StefanVlad01/Straight-toothed-bevel-gear-reducer/Assembly.SLDASM

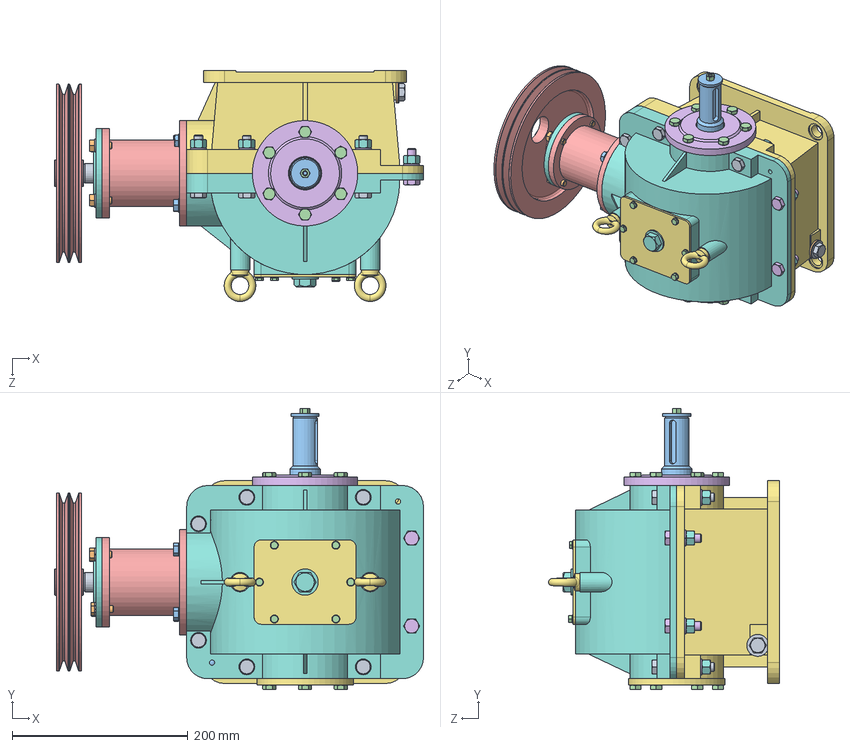
[picture p1: CAD file, 2023-03-10]
Assembly.SLDASM
420.1 x 320.4 x 263.0 mm
Arbore de intrare_1
taper roller bearing_din x 4
Arbore de iesire
Roata_condusa
Caseta rulment arbore intrare
Capac de fixare tip 2
Capac de fixare tip 1
Capac rulment arbore intrare
SKF_KM_5
SKF_MB_5
Inel
Inel 2
SKF_22X40X7_HMS5_V
SKF_35X52X8_HMSA10_V
Carcasa inferioara
Carcasa superioara.
ISO 4014 - M10 x 60 x 26 x 6
Washer ISO 7090 - 10
ISO 2339 - A - 6 x 32
ISO 4014 - M8 x 45 x 22-N x 12
Roata de curea
ISO 4014 - M10 x 30 x 26-N x 2
Capac de vizitare
Aerisitor_1
Spring washer DIN 128 - A8 x 8
ISO 4018 - M8 x 20-NN x 4
ISO 4018 - M8 x 45-NN x 4
ISO 4018 - M5 x 16 x 6
Spring washer DIN 128 - A5 x 6
Spring washer DIN 128 - A10 x 8
eyebolt580_din x 2
ISO - 4034 - M10 - N x 8
Dop de golire
Garnitura golire
Asigurare iesire
ISO - 4034 - M6 - N
