StefanVlad01/Straight-toothed-bevel-gear-reducer/Assembly drawing.pdf

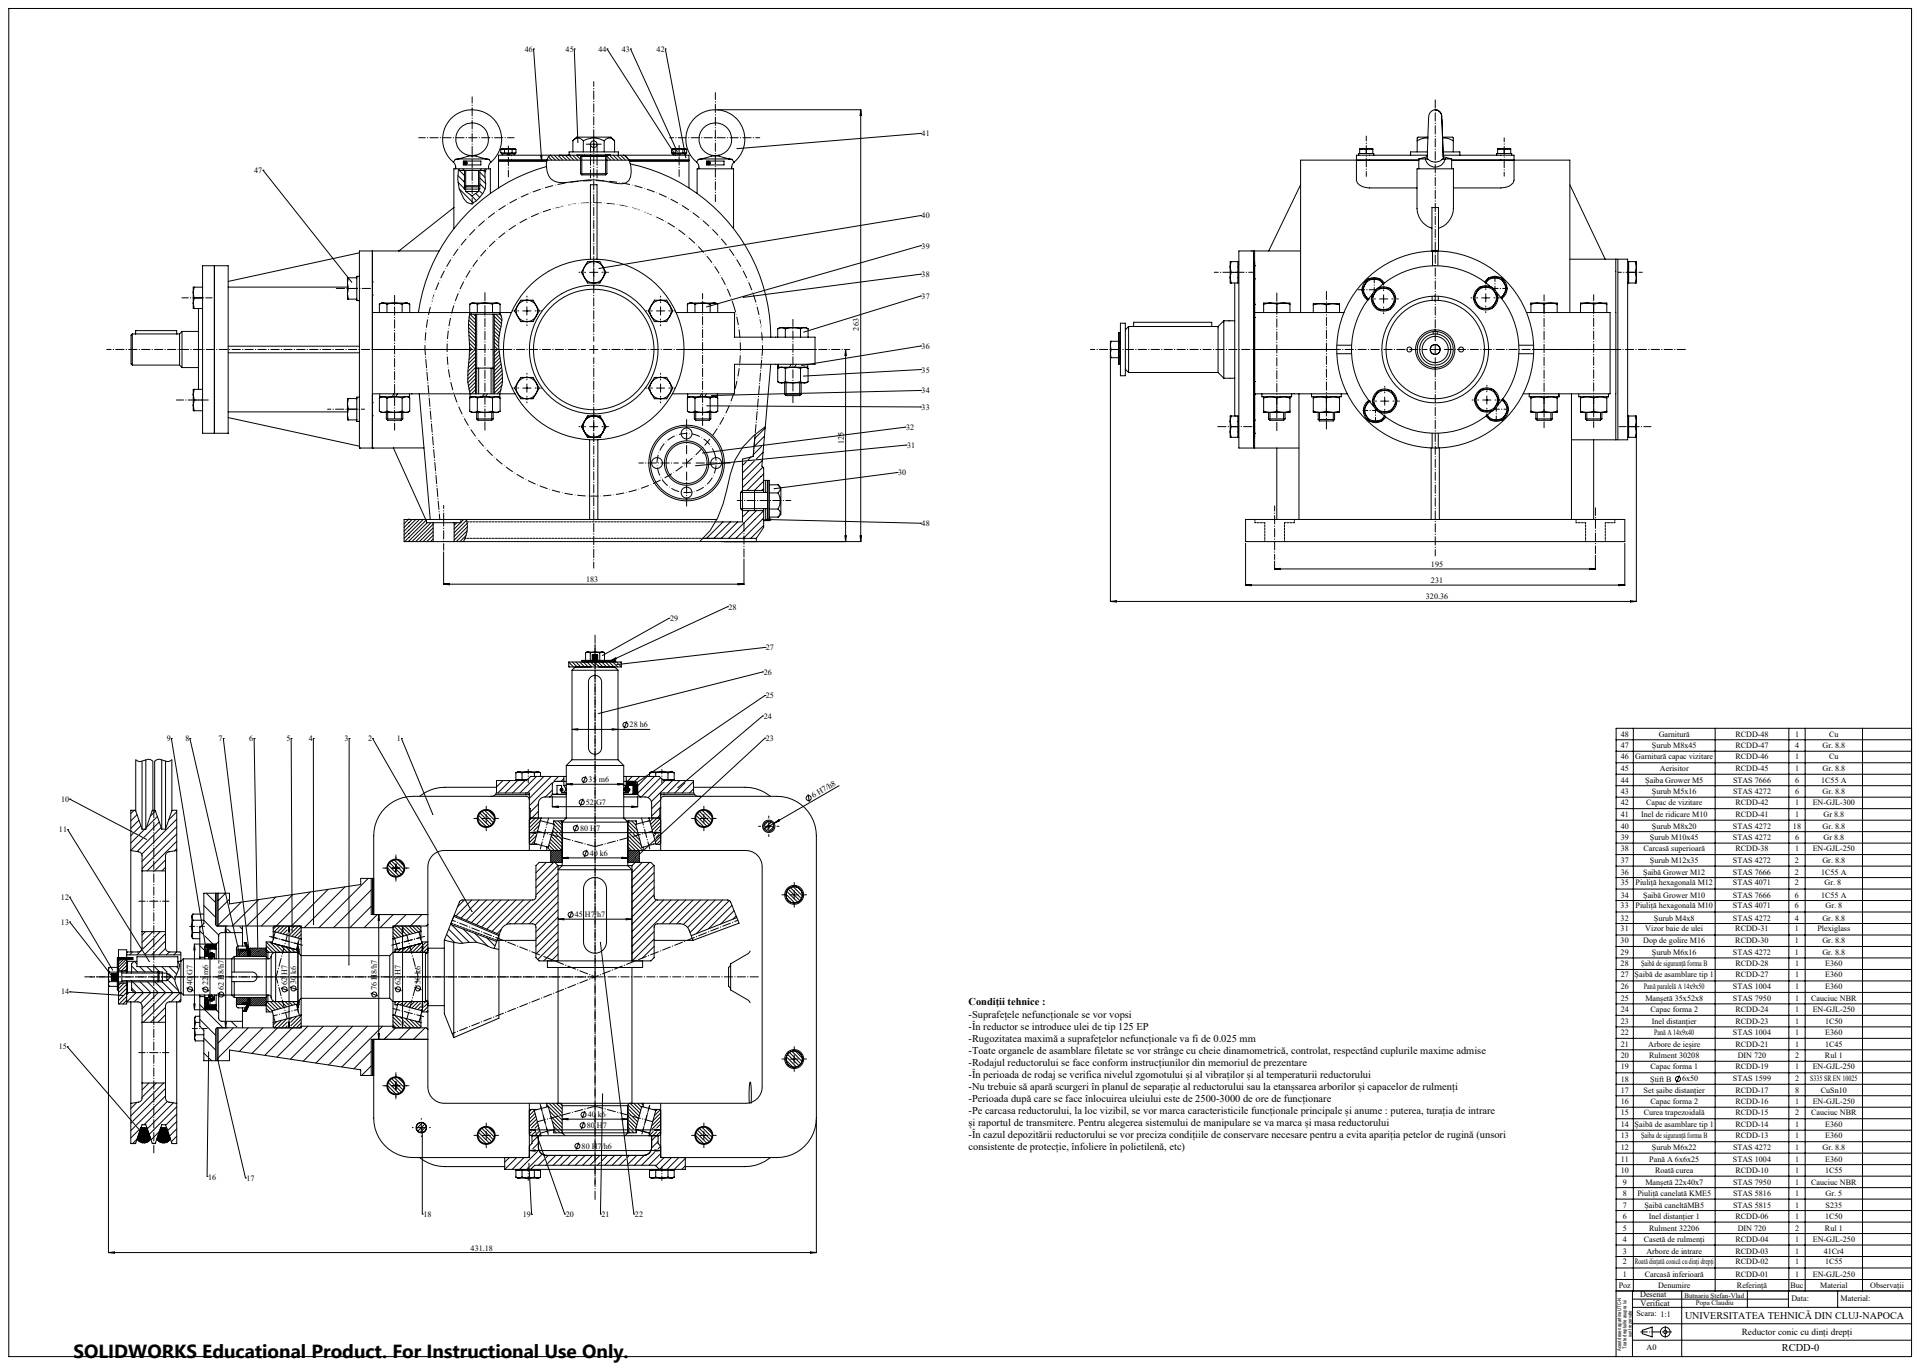
[picture p2: page 1]
sunt rezervate; Șurub M8x45; RCDD-47; 46 Garnitură capac vizitare; RCDD-46; Aerisitor; RCDD-45; Șaiba Grower M5; STAS 7666; Șurub M5x16; STAS 4272; Capac de vizitare; RCDD-42; EN-GJL-300; 41 Inel de ridicare M10; RCDD-41; Șurub M8x20; Șurub M10x45; Carcasă superioară; RCDD-38; EN-GJL-250; Șurub M12x35; Șaibă Grower M12; 35 Piuliță hexagonală M12; STAS 4071; Șaibă Grower M10; 33 Piuliță hexagonală M10; Șurub M4x8; Vizor baie de ulei; RCDD-31; Plexiglass; Dop de golire M16; RCDD-30; Șurub M6x16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

Condiții tehnice :
-Suprafețele nefuncționale se vor vopsi
-În reductor se introduce ulei de tip 125 EP
-Rugozitatea maximă a suprafețelor nefuncționale va fi de 0.025 mm
-Toate organele de asamblare filetate se vor strânge cu cheie dinamometrică, controlat, respectând cuplurile maxime admise
-Rodajul reductorului se face conform instrucțiunilor din memoriul de prezentare
-În perioada de rodaj se verifica nivelul zgomotului și al vibraților și al temperaturii reductorului
-Nu trebuie să apară scurgeri în planul de separație al reductorului sau la etanșsarea arborilor și capacelor de rulmenți
-Perioada după care se face înlocuirea uleiului este de 2500-3000 de ore de funcționare
-Pe carcasa reductorului, la loc vizibil, se vor marca caracteristicile funcționale principale și anume : puterea, turația de intrare
și raportul de transmitere. Pentru alegerea sistemului de manipulare se va marca și masa reductorului
-În cazul depozitării reductorului se vor preciza condițiile de conservare necesare pentru a evita apariția petelor de rugină (unsori
consistente de protecție, înfoliere în polietilenă, etc)

Butnariu Ștefan-Vlad
Popa Claudiu
UNIVERSITATEA TEHNICĂ DIN CLUJ-NAPOCA

Acest desen apartine UTC-N
Scara:

Toate drepturile asupra lui

Reductor conic cu dinți drepți
RCDD-0

SOLIDWORKS Educational Product. For Instructional Use Only.
