StefanVlad01/Straight-toothed-bevel-gear-reducer/Bevel gear.pdf

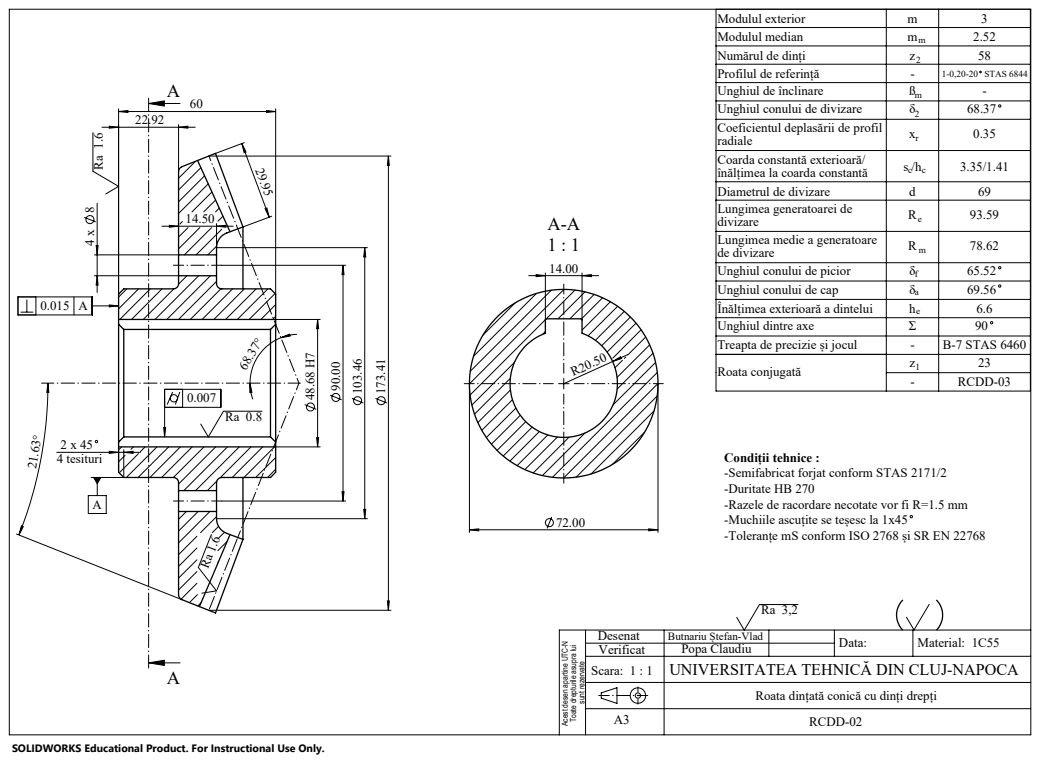
[picture p3: page 1]
sunt rezervate; 2 x 45 4 tesituri

Modulul exterior | m | 3
Modulul median | m m | 2.52
Numărul de dinți | z 2 | 58
Profilul de referință | - | 1-0,20-20 STAS 6844
Unghiul de înclinare | ß m | -
Unghiul conului de divizare | δ 2 | 68.37
Coeficientul deplasării de profil radiale | x r | 0.35

Coarda constantă exterioară/ înălțimea la coarda constantă | s /h c c | 3.35/1.41
Diametrul de divizare | d | 69
Lungimea generatoarei de divizare | R e | 93.59

Lungimea medie a generatoare de divizare | R m | 78.62

Unghiul conului de picior | δ f | 65.52
Unghiul conului de cap | δ a | 69.56
Înălțimea exterioară a dintelui | h e | 6.6
Unghiul dintre axe | Σ | 90
Treapta de precizie și jocul | - | B-7 STAS 6460
Roata conjugată | z 1 | 23

- RCDD-03

Condiții tehnice :
-Semifabricat forjat conform STAS 2171/2
-Duritate HB 270
-Razele de racordare necotate vor fi R=1.5 mm
-Muchiile ascuțite se teșesc la 1x45
-Toleranțe mS conform ISO 2768 și SR EN 22768

Butnariu Ștefan-Vlad
Popa Claudiu
UNIVERSITATEA TEHNICĂ DIN CLUJ-NAPOCA

Acest desen apartine UTC-N

Toate drepturile asupra lui

Roata dințată conică cu dinți drepți

SOLIDWORKS Educational Product. For Instructional Use Only.
