StefanVlad01/Straight-toothed-bevel-gear-reducer/Gear shaft.pdf

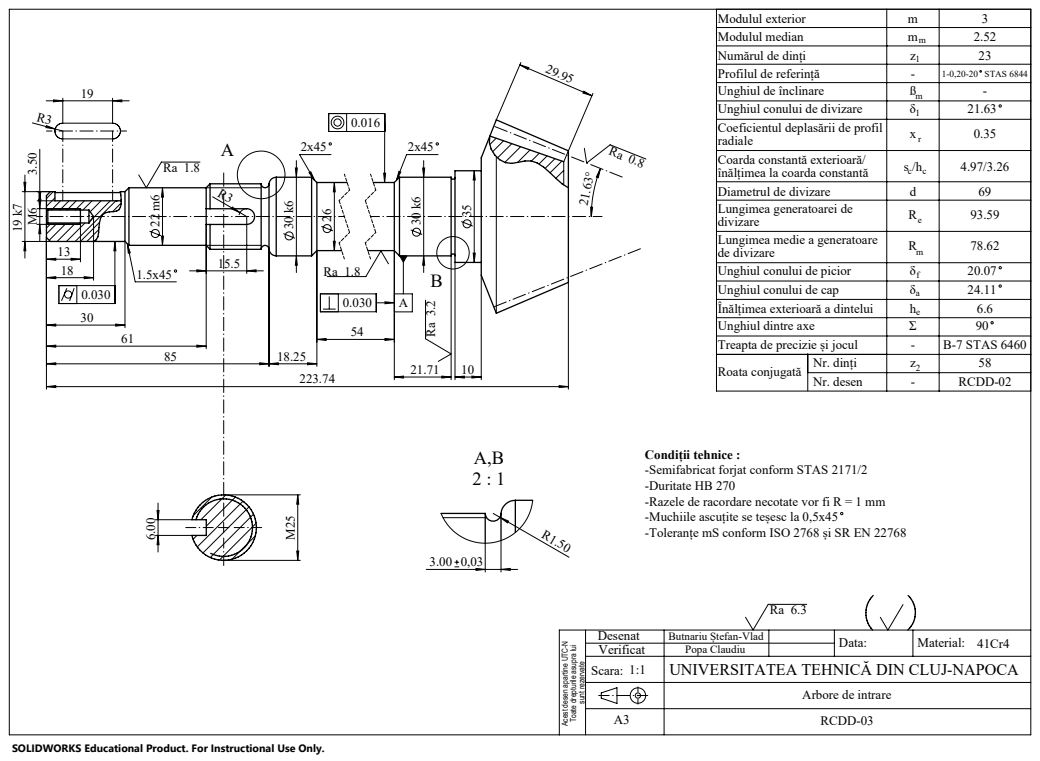
[picture p4: page 1]
sunt rezervate

Modulul exterior | m | 3
Modulul median | m m | 2.52
Numărul de dinți | z 1 | 23
Profilul de referință | - | 1-0,20-20 STAS 6844
Unghiul de înclinare | ß m | -
Unghiul conului de divizare | δ 1 | 21.63
Coeficientul deplasării de profil radiale | x r | 0.35

Coarda constantă exterioară/ înălțimea la coarda constantă | s /h c c | 4.97/3.26
Diametrul de divizare | d | 69
Lungimea generatoarei de divizare | R e | 93.59

Lungimea medie a generatoare de divizare | R m | 78.62

Unghiul conului de picior | δ f | 20.07
Unghiul conului de cap | δ a | 24.11
Înălțimea exterioară a dintelui | h e | 6.6
Unghiul dintre axe | Σ | 90
Treapta de precizie și jocul | - | B-7 STAS 6460
Roata conjugată | Nr. dinți | z 2 | 58

Nr. desen | - RCDD-02

Condiții tehnice :
-Semifabricat forjat conform STAS 2171/2
-Duritate HB 270
-Razele de racordare necotate vor fi R = 1 mm
-Muchiile ascuțite se teșesc la 0,5x45
-Toleranțe mS conform ISO 2768 și SR EN 22768

Butnariu Ștefan-Vlad
Popa Claudiu
UNIVERSITATEA TEHNICĂ DIN CLUJ-NAPOCA

Acest desen apartine UTC-N

Toate drepturile asupra lui

Arbore de intrare
RCDD-03

SOLIDWORKS Educational Product. For Instructional Use Only.
